Jehanzeb1973/Ardu_ECU/Components/CK1602 Power Supply.jpg

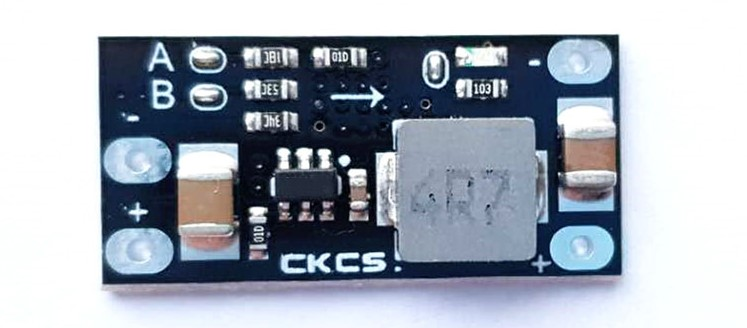
Components/CK1602 Power Supply.jpg
