Jehanzeb1973/Ardu_ECU/Components/LR-7843.jpg

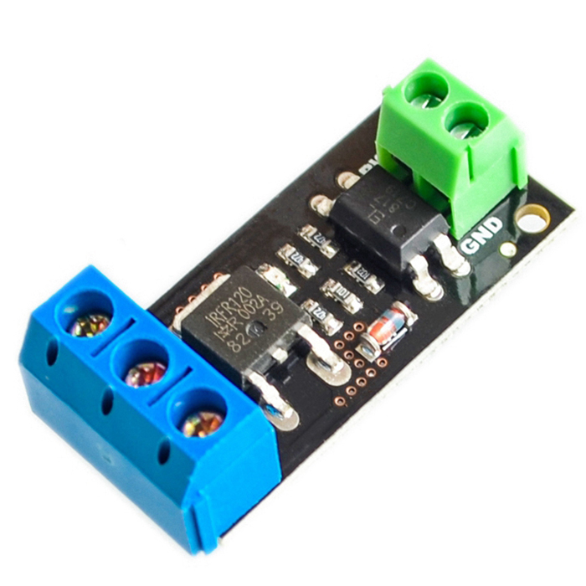
Components/LR-7843.jpg
