Jehanzeb1973/Ardu_ECU/Components/5v-to-3-3v-logic-level-converter-500x500.jpg

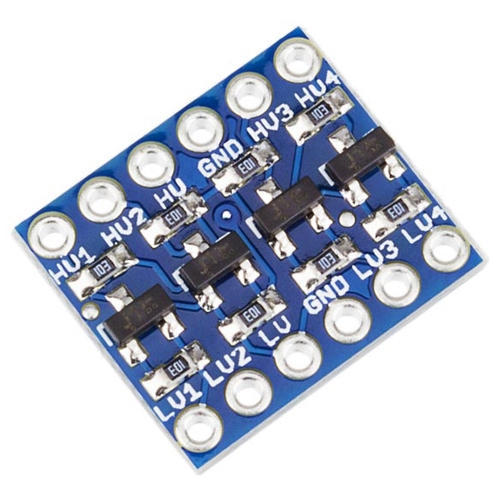
Components/5v-to-3-3v-logic-level-converter-500x500.jpg
