Jehanzeb1973/Ardu_ECU/Components/ESP32 Dev Kit.jpeg

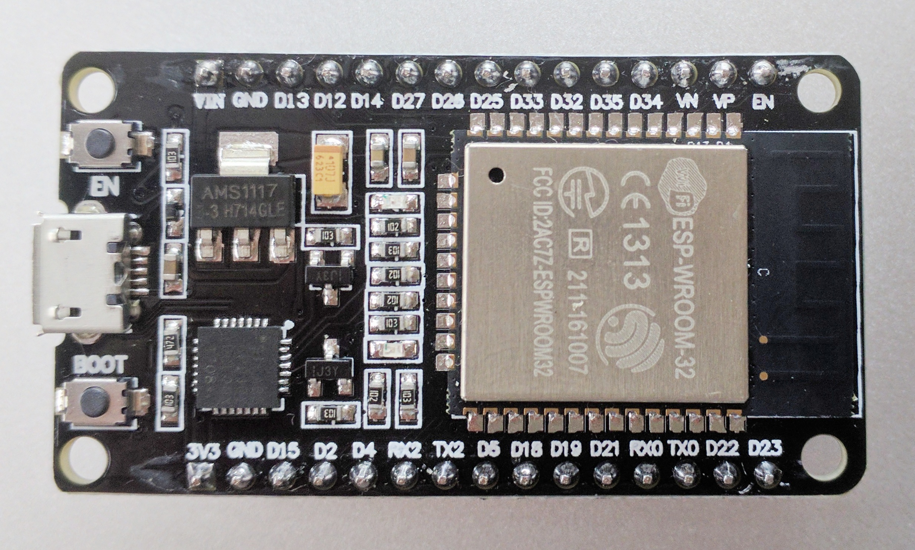
Components/ESP32 Dev Kit.jpeg
