Jehanzeb1973/Ardu_ECU/3D Printable Files/Brushed motor mount.stl

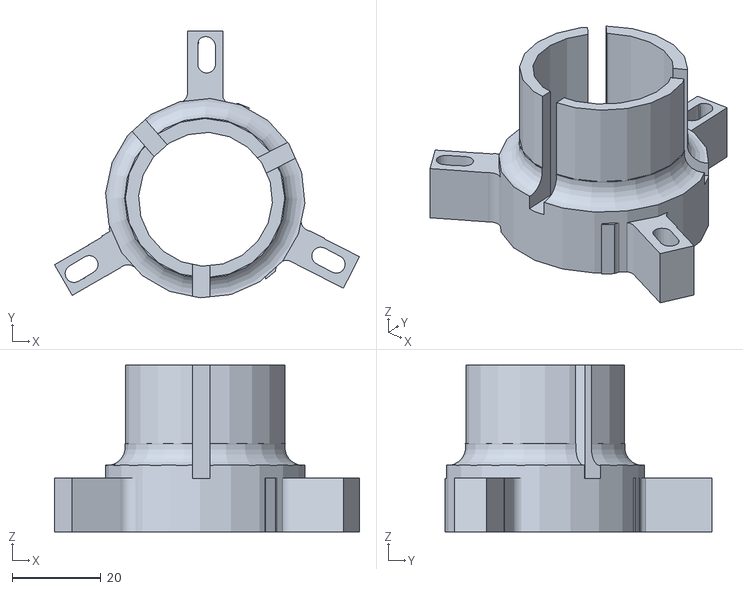
[picture p5: CAD file, 2023-07-19]
3D Printable Files/Brushed motor mount.stl
68.9 x 60.2 x 37.6
