Jehanzeb1973/Ardu_ECU/3D Printable Files/Bendix Sleeve.stl

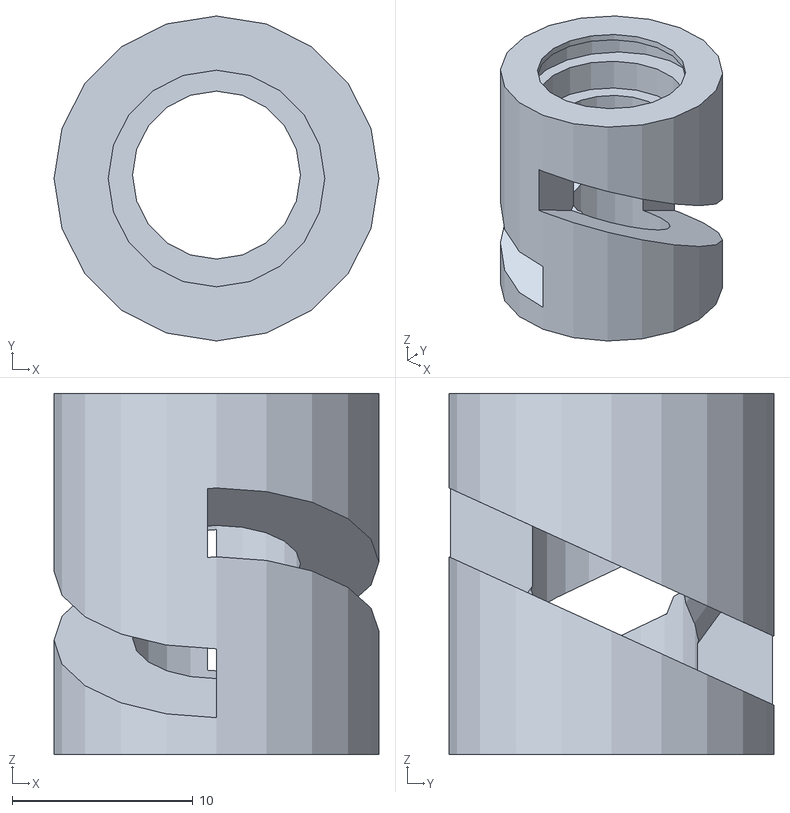
[picture p6: CAD file, 2023-07-13]
3D Printable Files/Bendix Sleeve.stl
18.0 x 18.0 x 20.0
