Jehanzeb1973/Ardu_ECU/3D Printable Files/Brushless motor mount.stl

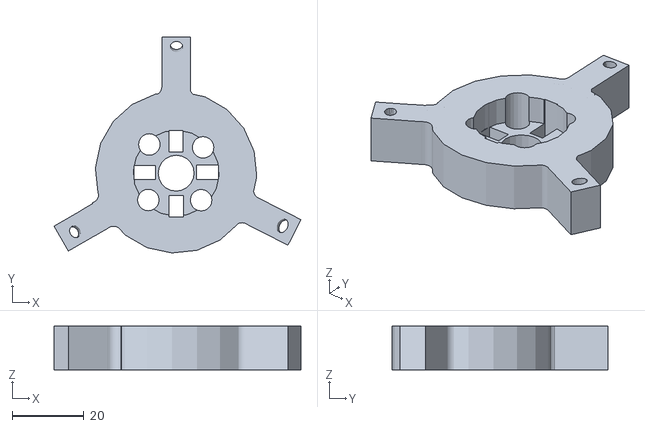
[picture p7: CAD file, 2023-02-14]
3D Printable Files/Brushless motor mount.stl
68.9 x 60.2 x 12.2
