Jehanzeb1973/Ardu_ECU/(threads)

Thread 5 (2023-03-26):

Working together

JoachimF, 2023-03-26:
Hello,

What do you think about working together?
You have the code, I have the PCB.
I'am working on IDF 5.
Take look on my git : https://github.com/JoachimF/JF-ECU32/tree/Dev

Best regards,

Joachim

Jehanzeb1973, 2023-03-26:
Hi Joachim
Yes, definitely. Together we can learn from each other and have a better product. With IDF sure the performance will be better as well. Are you using your code in a commercial product ?
Regards

Jehanzeb Khan
Mob: +92(0333) 5277770

http://DigiPak.org/

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

JoachimF, 2023-03-26:
Hi Jehanzeb,

I'm not planning to make commercial products, but if someone wants a built pcb, i'll sell it, if I have time ;-)
I haven't a lot of time for this project, but I want to finish it, I plan to make a screen and button module, connected by ESPNow to the ECU, I made a test for fun here : https://www.youtube.com/shorts/hG00hpaiWng

What about you port your code on my pcb to verify all IO are Ok, and try to port your code on IDF?

I can send you a pcb, I ordered the first prototype, I made some mistakes and some things are missing, but It's exploitable I think.
I corrected the PCB now, voltage are OK and the starter has a brake.

Jehanzeb1973, 2023-03-27:
Hi Joachim
The Arduino ECU code is easily portable. All input output pins are defined at the beginning of code so should be easily changeable. The only exception I believe is max6675/31855 pins are these are defined by library. I will look at the pcb and try to update the code. I can send you the updated ino. file so you can try it yourself and tell me how it went. In our company, we will go commercial with these PCB’s at come point although they will still be open source so if anyone wants to make it themselves, they can.
The screen you made looks quiet neat. Well done on that. As you have probably seen, we took a different approach and put all user interface as web based to keep the ECU minimal. I am sure some people will like it and some would want a dedicated terminal like you are designing.
Regards

Jehanzeb Khan
DIGIPAK Pvt. Limited

http://DigiPak.org/

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

Jehanzeb1973, 2023-03-27:
I saw that you were doing multitasking. Are you using a check to ensure no task takes longer than a certain time ?
My Arduino based sketch is a single thread which goes through each task sequentially so I have looked at time consumption of each task. The main control loop is very fast and takes less than 1 ms. Webserver in Arduino is consuming 100ms and SD Write is taking between 5-30ms so I have to time them so they don’t slow down the entire control loop. This is where probably IDF will be much faster. Also , I was thinking of using internal flash but now I have gone the route of micro SD card.
regards

Jehanzeb Khan
DIGIPAK Pvt. Limited

http://DigiPak.org/

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

JoachimF, 2023-03-27:
On the idf, the multitasking is preemptive, so task cannot exeed a tick. I
synchronise them with events. I can verify with the task manager if a task
over use the cpu, like Windows.
There are tool to verify memory leaks, and I use a debugger.

Le lun. 27 mars 2023 à 21:27, Jehanzeb Khan ***@***.***> a
écrit :

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

Thread 13 (2024-05-07):

Libraries

EFlynn7778, 2024-05-07:
Can you upload the used requisite libraries?  The Arduino IDE library manager libraries do not compile. Particularly the MAX31855 library returns type errors. None of the MAX31855 libraries i can find work.

Please specify the libraries, and the version of libraries used as not all version of a particular library may compile for ESP32.

Also, can you include the HTML source as well as method of converting .h files so we can help with the web ui?
