Jehanzeb1973/Ardu_ECU/Schematics/Schematic_Ardu ECU_Rev 11.pdf

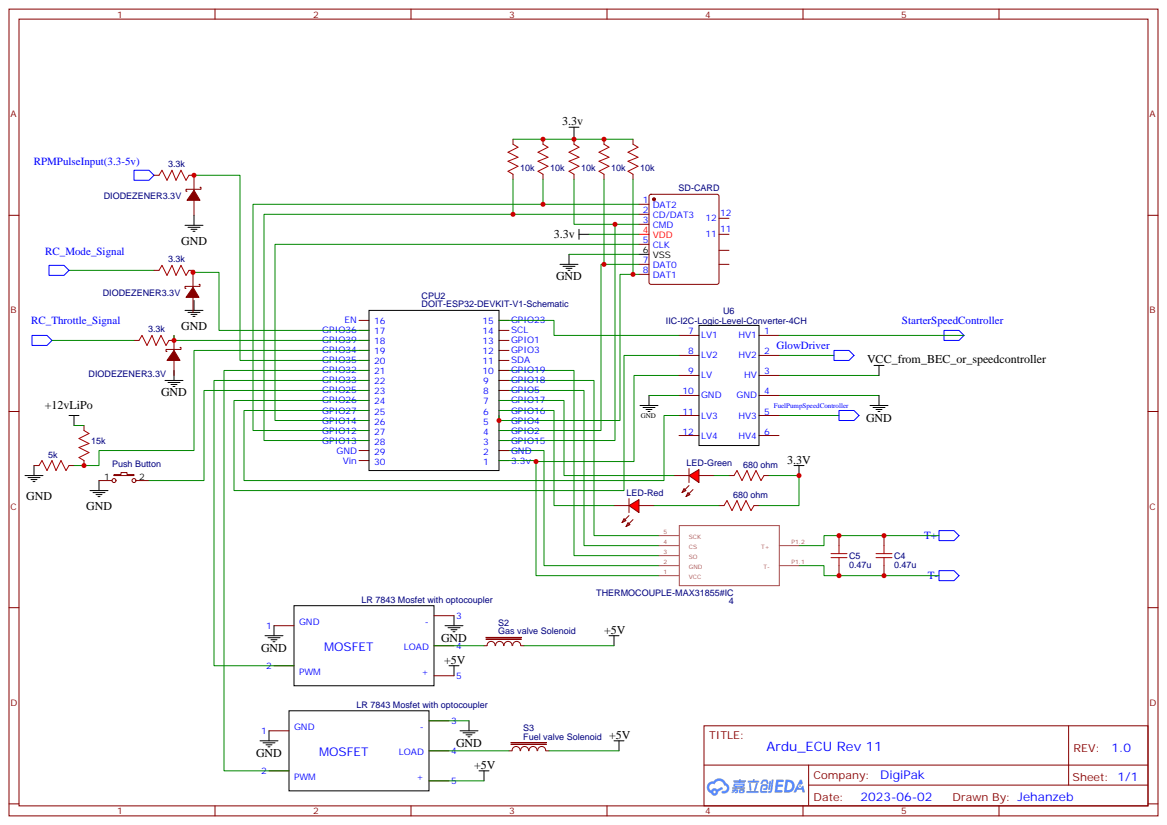
[picture p43: page 1]

LR 7843 Mosfet with optocoupler
