Jehanzeb1973/Ardu_ECU/Schematics/ECU Rev9-10 Schematic.pdf

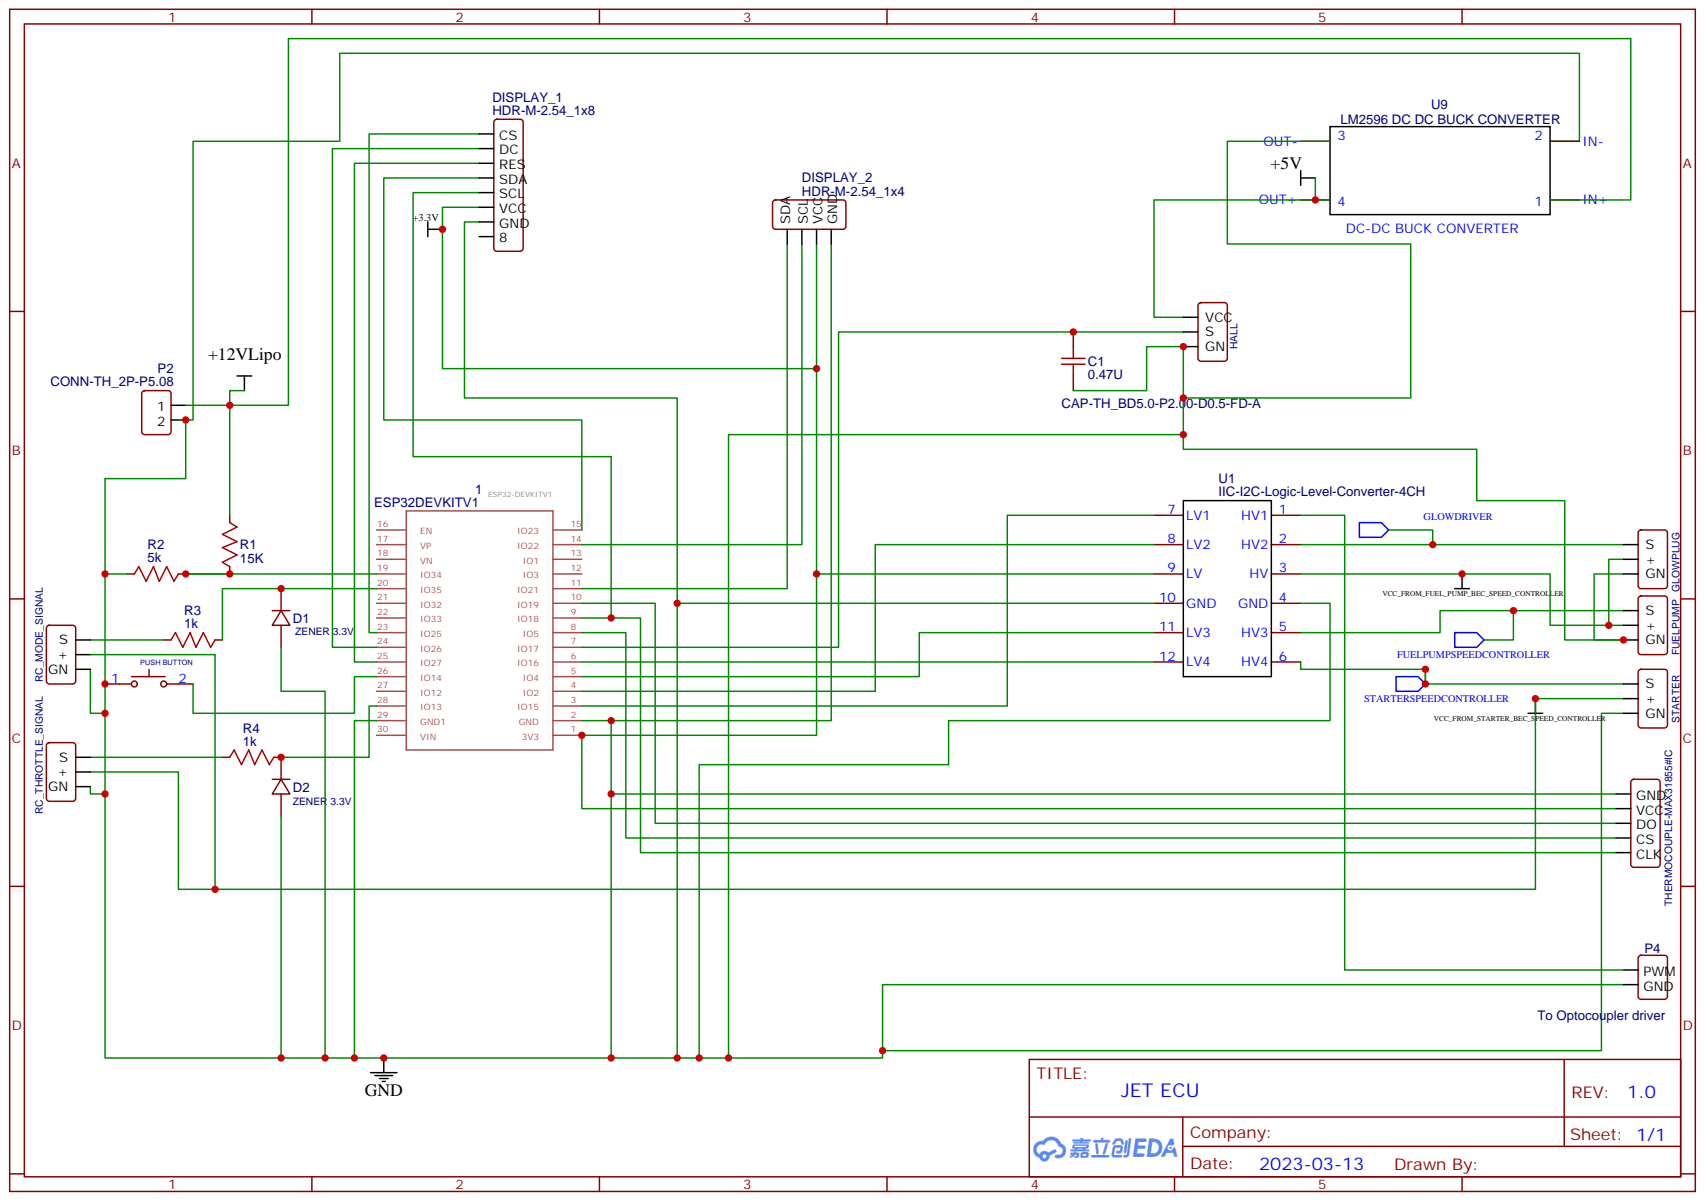
[picture p44: page 1]

LM2596 DC DC BUCK CONVERTER

DC-DC BUCK CONVERTER
