Jehanzeb1973/Ardu_ECU/(commit log)

2023-03-26 Add files via upload
    A much better schematic contributed by @dstromeng from Jet Innovate
2023-07-13 Add files via upload
    Bendix Sleeve STL file for 3d Print
    [Bendix Sleeve.stl]
